PeakSat/system-pcbs/PlusX_Cover/Components/PWR263S-35-56R0F/PWR263S-35-56R0F.stp

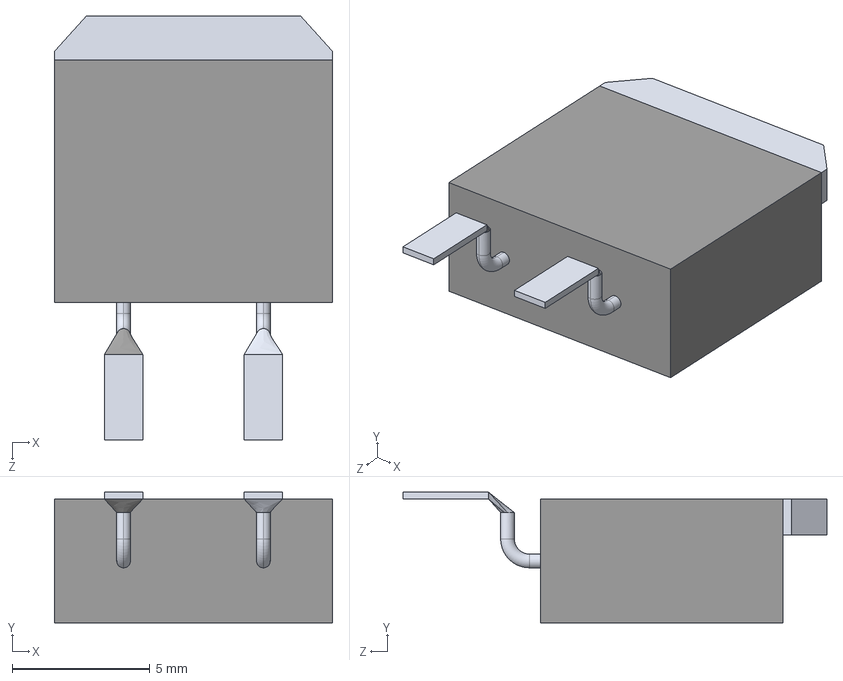
[picture p1: CAD file, 2024-11-10]
PlusX_Cover/Components/PWR263S-35-56R0F/PWR263S-35-56R0F.stp
10.1 x 4.75 x 15.4 mm
