PeakSat/system-pcbs/PlusX_Cover/Components/T2M-107-01-L-D-SM-DS/ABF_Mated_14.STEP

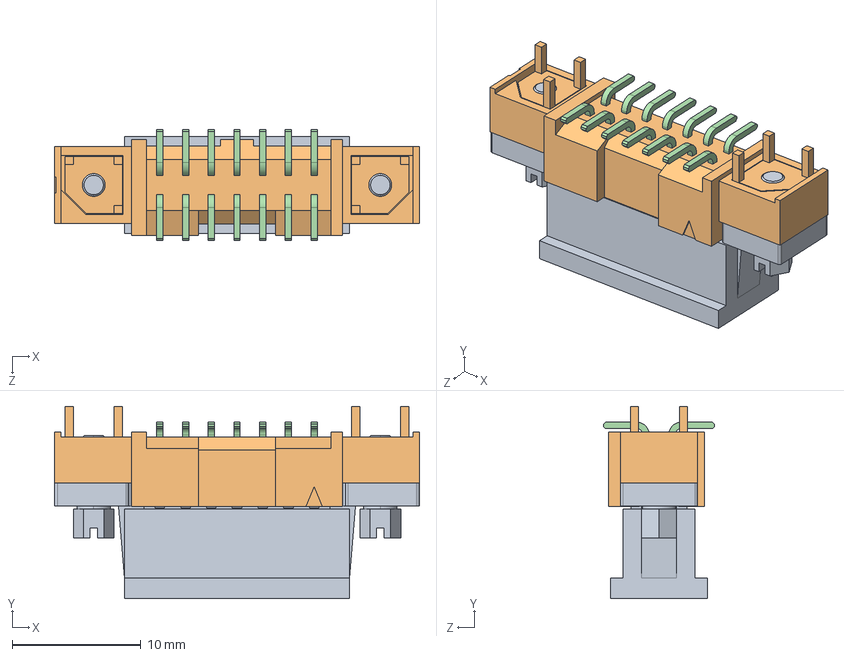
[picture p2: CAD file, 2024-11-07]
PlusX_Cover/Components/T2M-107-01-L-D-SM-DS/ABF_Mated_14.STEP
28.4 x 15.0 x 8.63 mm
ISD2-07-D-S
B1T2M-07-D-SM-DS.step
P2T2M-07-D-SM-DS.step
P22T2M-07-D-SM-DS.step
