PeakSat/system-pcbs/PlusX_Cover/Components/T2M-107-01-L-D-SM-DS/T2M-107-01-X-D-SM-DS.step

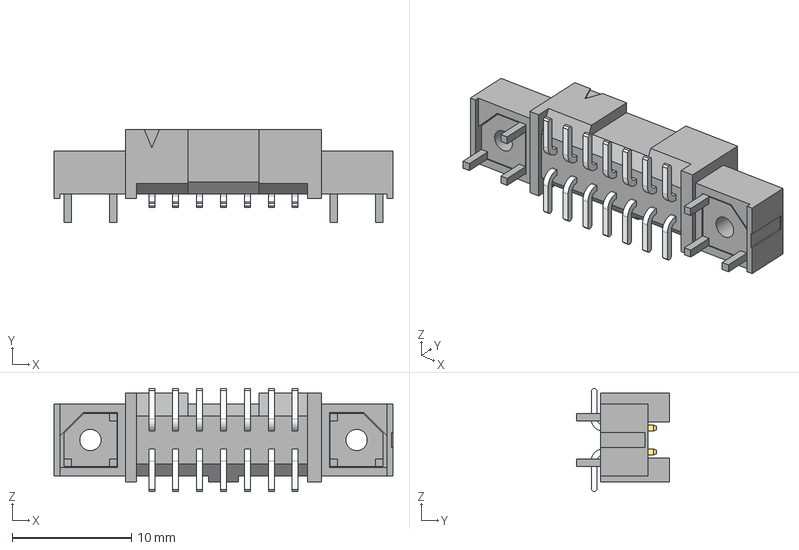
[picture p3: CAD file, 2024-11-07]
PlusX_Cover/Components/T2M-107-01-L-D-SM-DS/T2M-107-01-X-D-SM-DS.step
28.4 x 7.79 x 8.63 mm
B1T2M-07-D-SM-DS
P2T2M-07-D-SM-DS
P22T2M-07-D-SM-DS
