PeakSat/system-pcbs/PlusX_Cover/Components/504050-0291/504050-0291.stp

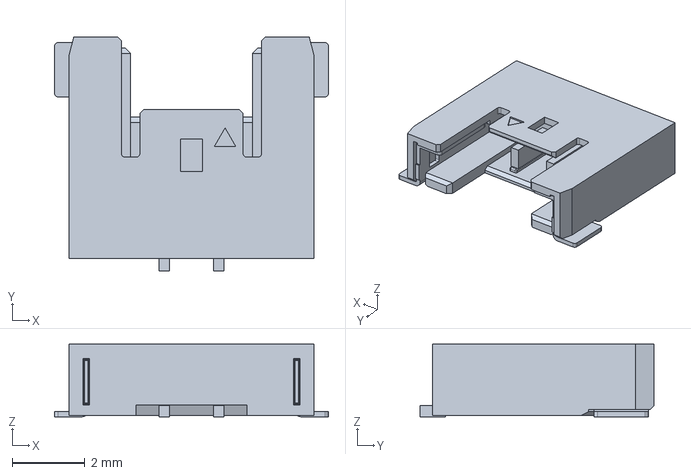
[picture p4: CAD file, 2024-11-10]
PlusX_Cover/Components/504050-0291/504050-0291.stp
7.55 x 6.44 x 2.00 mm
