PeakSat/system-pcbs/PlusX_Cover/Components/504050-0491/504050-0491.stp

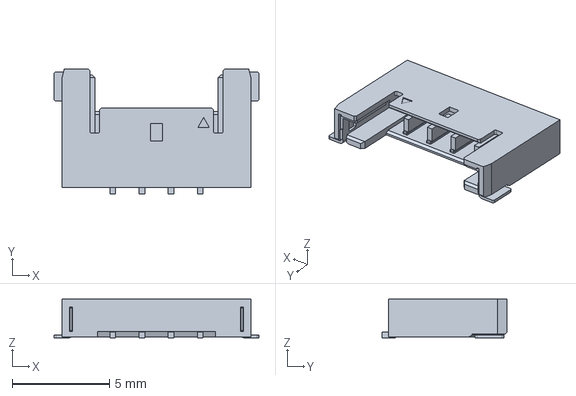
[picture p5: CAD file, 2024-11-08]
PlusX_Cover/Components/504050-0491/504050-0491.stp
10.6 x 6.44 x 2.00 mm
