PeakSat/system-pcbs/PlusX_Cover/Components/504050-0691/504050-0691.stp

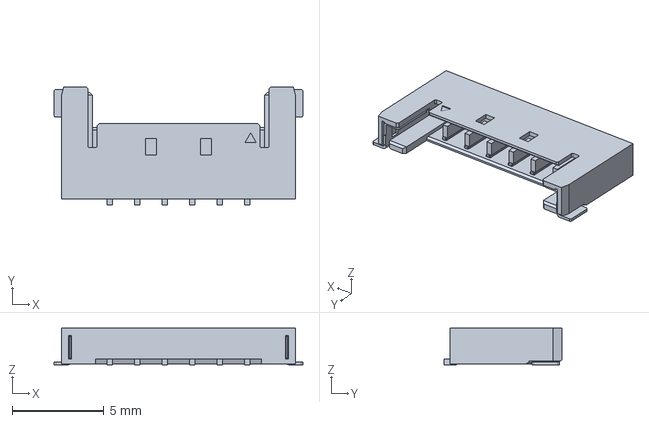
[picture p6: CAD file, 2024-11-08]
PlusX_Cover/Components/504050-0691/504050-0691.stp
13.6 x 6.44 x 2.00 mm
