PeakSat/system-pcbs/PlusX_Cover/Components/504050-1291/504050-1291.stp

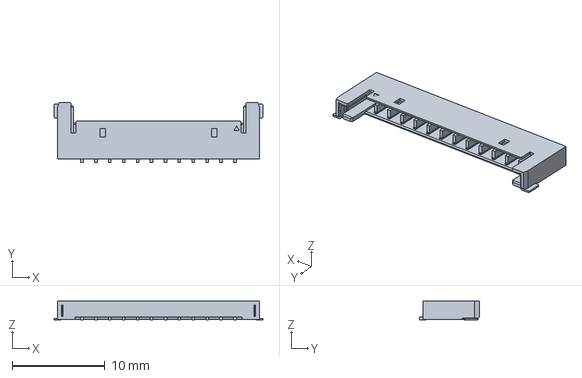
[picture p7: CAD file, 2024-11-08]
PlusX_Cover/Components/504050-1291/504050-1291.stp
22.6 x 6.44 x 2.00 mm
