PeakSat/system-pcbs/PlusX_Cover/Components/M80-8281042/M80-8281042.stp

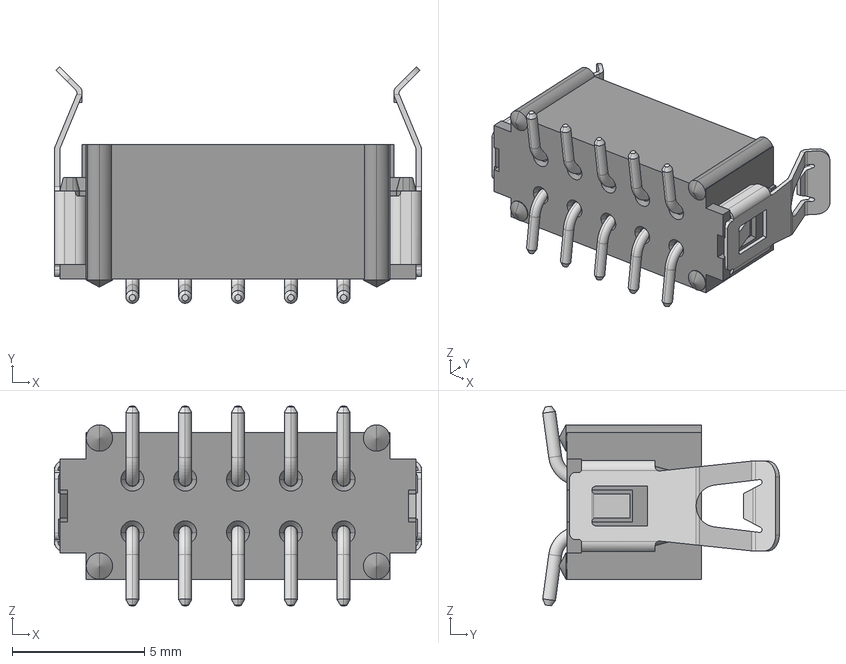
[picture p8: CAD file, 2024-11-08]
PlusX_Cover/Components/M80-8281042/M80-8281042.stp
13.9 x 8.96 x 7.56 mm
M80-1021898_SEPARATE_ROWS
M80-827XX05-PIN x 10
M80-001XXXX x 2
