PeakSat/system-pcbs/PlusX_Cover/Components/M80-8281242/M80-8281242.stp

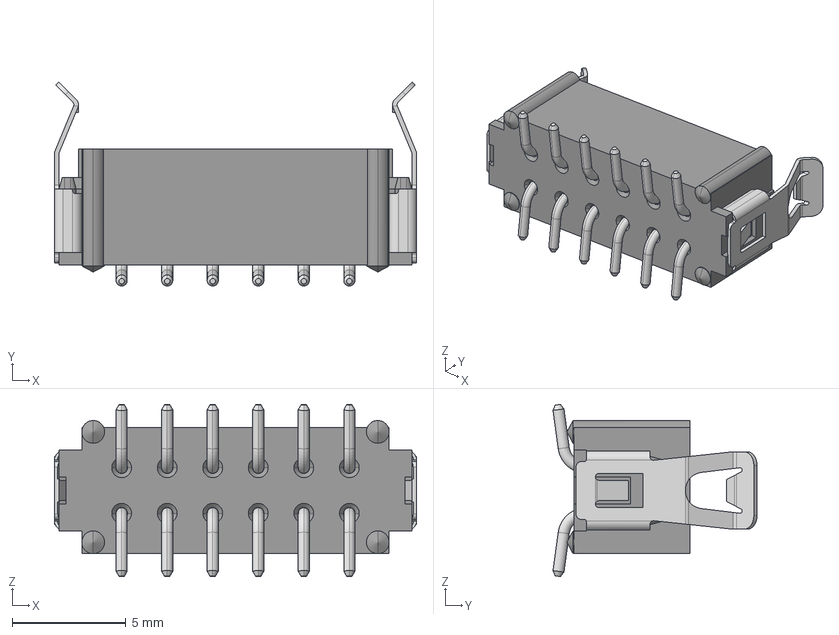
[picture p9: CAD file, 2024-11-10]
PlusX_Cover/Components/M80-8281242/M80-8281242.stp
15.9 x 8.96 x 7.56 mm
M80-1021898_SEPARATE_ROWS
M80-827XX05-PIN x 12
M80-001XXXX x 2
