PeakSat/system-pcbs/PlusX_Cover/Components/M80-8282642/M80-8282642.stp

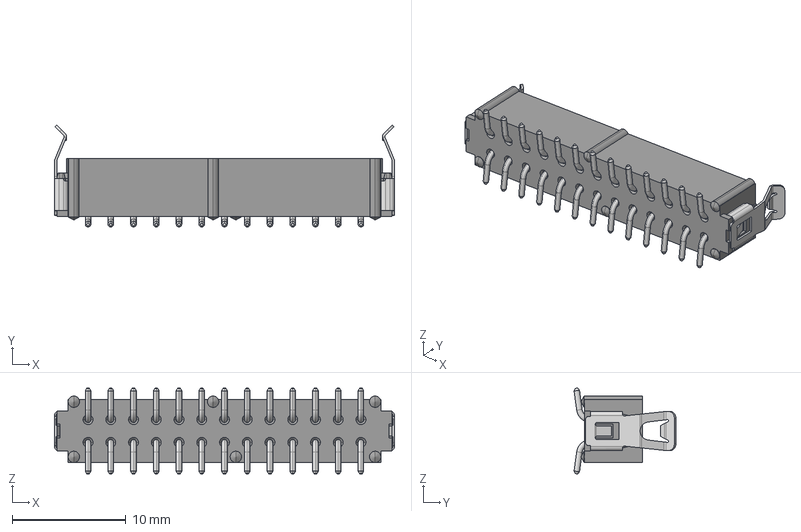
[picture p10: CAD file, 2024-11-08]
PlusX_Cover/Components/M80-8282642/M80-8282642.stp
29.9 x 8.96 x 7.56 mm
M80-1022698_SEPARATE_ROWS
M80-827XX05-PIN x 26
M80-001XXXX x 2
