PeakSat/system-pcbs/(threads)

Thread 1 (2024-11-06):

Design +X Cover PCB

maestroque, 2024-11-06:
- [ ] Umbilical connectors on both sides to be in par with the cable routing observations (two rows on the inside)
- [ ] Umbilical connectors on the outside to be accessible from the testpod window.
- [ ] ABF connector change to a locking one, potentially with screws.
- [ ] Check the adequacy of the ground plane around the GNSS antenna

maestroque, 2024-11-07:
ABF on +X Cover, PeakSat assembly. There is slack for the ABF cables of 7.8mm

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

maestroque, 2025-03-05:
Clearence from ExoPod NOVA

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

More than 1cm clearence for the screwdriver bit to lock the ABF. All other connectors are easily accessible
