PeakSat/system-pcbs/(commit log)

2024-11-05 +X Cover: Add internal interface
    [PlusX_Cover.kicad_sch]
2024-11-07 +X Cover: Add screw-down ABF connector and initial mechanical layout
    [ABF_Mated_14.STEP, PlusX_Cover.kicad_pcb, PlusX_Cover.kicad_sch, T2M-107-01-X-D-SM-DS.step]
2024-11-07 +X Cover: Finalize mechanical layout
    [PlusX_Cover.kicad_pcb]
2024-11-07 +X Cover: Add GNSS mounting
    [PlusX_Cover.kicad_pcb, PlusX_Cover.kicad_sch]
2024-11-08 +X Cover: Internal connector placement
    [504050-0491.stp, 504050-1291.stp, PlusX_Cover.kicad_pcb, PlusX_Cover.kicad_sch]
2024-11-08 +X Cover: Finalize external connector placement
    [504050-0691.stp, M80-8281042.stp, M80-8282642.stp, PlusX_Cover.kicad_pcb, PlusX_Cover.kicad_sch]
2024-11-08 +X Cover: Add gerbers
    [bom.csv, designators.csv, positions.csv]
2024-11-10 Add Sun and Earth Sensor Panel PCBs
    [EarthSensor_Panel.kicad_pcb, EarthSensor_Panel.kicad_sch, SunSensor_Panel.kicad_pcb, SunSensor_Panel.kicad_sch]
2024-11-10 +X Cover: Add temperature sensor connectors
    [504050-0291.stp, M80-8281242.stp, PlusX_Cover.kicad_pcb, PlusX_Cover.kicad_sch]
2024-11-10 +X Cover: Add kill resistors
    [PWR263S-35-56R0F.stp, PlusX_Cover.kicad_pcb, PlusX_Cover.kicad_sch]
2024-11-10 Kill resistor fix, step generation, gerbers
    [PlusX_Cover.kicad_pcb, PlusX_Cover.kicad_sch, bom.csv, designators.csv, positions.csv]
2024-11-12 Minor updates + gerbers
    [PlusX_Cover.kicad_pcb, PlusX_Cover.kicad_sch, designators.csv]
2024-11-13 +X Cover: Add RBF pin (optional)
    [PlusX_Cover.kicad_sch]
2024-11-25 Add GNSS Antenna cable routing notch
    [PlusX_Cover.kicad_pcb]
2025-01-08 +X Cover: Rotate STR cutout by -88.5 deg
    [PlusX_Cover.kicad_pcb]
2025-01-10 Fix +X Cover mechanical interface
    [PlusX_Cover.kicad_pcb]
2025-01-16 Increase STR cutout diameter to account for large tolerances
    [PlusX_Cover.kicad_pcb]
2025-01-16 +X Cover: Complete routing and annotations
    [PlusX_Cover.kicad_pcb]
2025-01-24 Add BOM
    [PlusX_Cover.kicad_sch]
2025-03-05 +X PCB: Minor fix
    [PlusX_Cover.kicad_pcb, PlusX_Cover.kicad_sch]
2025-04-02 X Cover: Flight Ready Cosmetics
    [PlusX_Cover.kicad_pcb, bom.csv, designators.csv, positions.csv]
2025-04-02 Add -Z Cover PCB
    [MinusZ_Cover.kicad_pcb, MinusZ_Cover.kicad_sch, designators.csv]
2025-04-23 Add Star Tracker VBAT-to-5.2V converter PCB
    [Star_Tracker_Converter_PCB.kicad_pcb, Star_Tracker_Converter_PCB.kicad_sch]
2025-04-25 Minor fixes
    [Star_Tracker_Converter_PCB.kicad_pcb, Star_Tracker_Converter_PCB.kicad_sch]
2025-04-25 Add STM32 circuit and 3V3 PSU
    [Star_Tracker_Converter_PCB.kicad_sch, mcu.kicad_sch]
2025-05-06 Add Star Tracker Converter PCB production files
    [Star_Tracker_Converter_PCB.kicad_pcb, Star_Tracker_Converter_PCB.kicad_sch, bom.csv, designators.csv, positions.csv]
2025-05-06 Add Alignment Model Panels
    [MNX_Panel_Alignment.kicad_pcb, MNX_Panel_Alignment.kicad_sch, MNY_Panel_Alignment.kicad_pcb, MNY_Panel_Alignment.kicad_sch]
