PeakSat/system-pcbs/(notices)

Notices in the files:
PlusX_Cover/Components/T2M-107-01-L-D-SM-DS/T2M-107-01-X-D-SM-DS.step:
author */ ('License CC BY-ND 4.0'),
